jamespilgrim/PiTrac/Documentation/PiTrac - DIY LM  Parts List.md

**PiTrac \- DIY LM  Parts Lists**

**Computing Hardware:**

| Quantity | Hardware | Purpose |
| :---- | :---- | :---- |
| 1 | [Raspberry Pi 5](https://www.raspberrypi.com/products/raspberry-pi-5/) and power supply, 4 GB minimum, 8 FB recommended. | Getting a bundled kit with the Pi and power supply and some other things can be economical if you don’t have any Pi-related stuff yet. |
| 1 | [Raspberry Pi 4 Model B](https://www.raspberrypi.com/products/raspberry-pi-4-model-b/) and power supply, 4 GB minimum.  It may also make sense for a little more money just to get a second Pi 5\. |  |
| 1 | [Pimoroni NVMe Base for Raspberry Pi 5 \- PIM699](https://www.adafruit.com/product/5845) ((optional, but recommended for speed and longevity). [This board](https://www.amazon.com/gp/product/B0CQ4D2C9S/ref=ppx_yo_dt_b_search_asin_title?ie=UTF8&psc=1) works well, too. | For the Pi 5, this allows use of an NVMe memory drive instead of an MicroSD card. |
| 1 | An [NVMe solid state (SSD) memory drive](https://www.amazon.com/gp/product/B0BGFRZDTB/ref=ppx_yo_dt_b_search_asin_title?ie=UTF8&psc=1) (optional, but recommended for speed and longevity) | Typically with an M.2 M key edge connector, in the 2230 and 2242 form factors.  Should probably get at least 256 GB capacity. |
| 2 | Micro SD cards (to bootstrap the Pi’s). | We recommend 64GB size |
| 1 | An Active Cooler fan for the Pi 5 (optional) | The Pi 5 can get pretty hot if you’re doing a lot of big compiles on it.  If so, having a cooler seems like decent insurance. |

**Hardware \- Bolts and Nuts:[^1]**

| Quantity | Hardware | Purpose |
| :---- | :---- | :---- |
| 4 | M4 x 12 screws | LED Power supply hold-downs |
|  |  |  |
| 4 | 2.5M x 12mm bolt | Pi 1 Board Bolt-down |
| 4 | 2.5 Hex Nuts | Pi 1 Board Bolt-down |
| 3 | 2.5M x 10mm bolt | Pi 2 Board Bolt-down |
| 1 | 2.5M x 12mm bolt (odd one\!) | Pi 2 Board Bolt-down |
|  |  |  |
| 2 x 4 | 2.5M x 16mm 2.5 Hex Nuts | Pi Camera Attachment Bolts (to back plate) |
| 3 x 2 3 x 2 | M4 x 12mm  M4 Hex Nuts  | Pi Cam Gimbal Attachment Hinge (2 cameras and strobe gimbal) |
| 2 x 1 2 x 1 | M5 x 12 M5 Hex Nut | Pi Cam (Pan) Swivel Mount (on bottom of mount) |
|  |  |  |
| 3 x 2 | M3 | Horizontal Center-Side Body Attachment |
| 4 | 2.5 x 10 or 12 | Connector Board Bolt-down |
| 3 x 6 \= 18 | M3 x 10mm | Floor hold-down screws |
|  |  |  |
| 2 x 4 | 2.5M x 12mm bolt | Connector Board Mounting Bolts |
| 2 x 4 | 2.5 Hex Nuts | Connector Board Mounting Bolts |
| 8 | M3 x 10mm | LED and LED Lens Hold-down screws |
|  |  |  |
| 2 2 | M3 x 12mm M3 Nuts | Half-Join bolts and nuts for ceiling level walls |
| 2 2 | M3 x 16mm M3 Nuts | Half-Join bolts and nuts for base and middle level walls |
| 5 x 4 | M3 x 10mm self-tapping screws | These screws secure the five “floor” components to their respective “wall” components and/or other floor components |

**Camera and Lighting Hardware:**

| 2  | [Raspberry Pi Global Shutter Camera – CS Lens Mount](https://www.adafruit.com/product/5702) | The cameras currently used by the LM.  They do not come with lenses (see below) |
| :---- | :---- | :---- |
| 1 | [Raspberry Pi 5 FPC Camera Cable \- 22-pin 0.5mm to 15-pin 1mm \- 300mm long](https://www.adafruit.com/product/5819) | The current Pi Cameras have a CSI cable that needs a conversion to fit into the smaller CSI ports on the Pi 5\.  The 200mm should probably work as well. |
|  | [200 mm Flex Cable for Pi 4](https://www.adafruit.com/product/2087) | This likely comes with most Pi Cameras, so may not be necessary |
| 2 | [6mm 3MP Wide Angle Lens for Raspberry Pi HQ Camera \- 3MP](https://www.adafruit.com/product/4563) | Wide angle lens for the Pi GS cameras (which come without a lens) |
| 1 | [1" x 1", Optical Cast Plastic IR Longpass Filter](https://www.edmundoptics.com/p/1quot-x-1quot-optical-cast-plastic-ir-longpass-filter/5421/) (1.5mm nominal thickness) | Blocks visible light below 850nm from entering the Camera 2 sensor |
|  |  |  |
| 1 | [60 / 120 Degree LED Lens Optical Glass 44mm \+ Reflector Collimator \+ Fixed Bracket for 20W 30W 50W 100W COB High Power Chip (60Degree 100W len kit)](https://www.amazon.com/dp/B09XK7QTV5?ref=ppx_yo2ov_dt_b_fed_asin_title)  | The lens helps focus the infrared IR light. |
| 1 | [High Power LED Chip IR 730nm (you want the 850nm) 850nm 940nm 3W 5W 10W 20W 30W 50W 100W COB Integrated Matrix Light Beads for Night Vision Camera (Select the 850NM, 100W 1Pieces)](https://www.amazon.com/dp/B09DPJYRQN?ref=ppx_yo2ov_dt_b_product_details&th=1)  | The 730nm IR Led used for strobe light.  NOTE \- this device can get very hot if left constantly on for even a few seconds.  PiTrac just uses it in short pulses. |
| 1 | [Aclorol USB COB LED Strip Lights for TV 5V USB Powered LED Tape Lights Daylight White 6.56FT 320Leds/M 6000K COB Flexible Light Strip TV Led Backlight for Bedroom Under Cabinet Kitchen DIY](https://www.amazon.com/Aclorol-Powered-Daylight-Flexible-Backlight/dp/B0D1FYV3LM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) | LED strip for lighting the teed-up ball- long enough to double it for more light. 
NOTE - The Strip should produce NO infrared light, or else it will interfere with the IR strobing that the system uses.
|

**Power-Related Parts:**

| 1  | LED Driver, 12-26V, Output Current DC 3600mA, such as: https://www.aliexpress.us/item/2251832563139779.html NOTE - Also need a power-plug for some of these drivers that just come with power wires.  For the US, see, e.g., [this](https://www.amazon.com/sspa/click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)| Driver for LED strobe array. Because of the short pulses that are used in the LM, a much smaller (and cheaper) driver may also work, possibly even a non-constant-current driver. |
| :---- | :---- | :---- |
| 1 | A 5V USB-B power supply with a male micro USB connector  | This is currently necessary to run the Connectro Board.  The supply is used as an isolated, independent (downstream of a transformer) power plane to try to keep the Pi’s and the Pi Camera safe. |
|  |  |  |

**Connector Board Parts:**

| Item | Qty | Reference(s) | Value | LibPart | Footprint / Details |  |
| :---- | :---- | :---- | :---- | :---- | :---- | ----- |
| 1 | 1 | J3 | \~ | [USB B Micro Female Pinboard](https://www.amazon.com/Pinboard-MELIFE-Interface-Adapter-Breakout/dp/B07W6T97HZ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) | The included Pin headers can be used for the parts below |  |
| 2 | 2 | R1, R4 | 330 ohm R | Resistor A decent assortment kit is [here](https://www.amazon.com/gp/product/B003UC4FSS/ref=ppx_yo_dt_b_search_asin_title?ie=UTF8&psc=1) | Resistor\_THT:R\_Axial\_DIN0207\_L6.3mm\_D2.5mm\_P10.16mm\_Horizontal |  |
| 3 | 2 | R2, R3 | 270 ohm R | Resistor | Resistor\_THT:R\_Axial\_DIN0207\_L6.3mm\_D2.5mm\_P10.16mm\_Horizontal |  |
| 5 | 1 | Sys1\_Conn1 | \~ | 4 Pin Header | Connector\_PinHeader\_2.54mm:PinHeader\_1x04\_P2.54mm\_Vertical |  |
| 6 | 1 | Sys2\_Conn1 | \~ | 3 Pin Header | Connector\_PinHeader\_2.54mm:PinHeader\_1x03\_P2.54mm\_Vertical |  |
| 7 | 2 | U2, U3 | H11L1 | [Isolator:H11L1](https://www.amazon.com/dp/B09KM2BJCF?ref_=pe_386300_442618370_TE_sc_as_ri_0) | Package\_DIP:DIP-6\_W7.62mm |  |
| 8 | 1 | U4 | 74HC04 | 74xx:74HC04 | Package\_DIP:DIP-14\_W7.62mm\_Socket |  |
| 9 | 1 | U5 | \~ | [Dual\_Mos\_Driver\_Module](https://www.amazon.com/Anmbest-High-Power-Adjustment-Electronic-Brightness/dp/B07NWD8W26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) | Verdant\_Custom\_Footprint\_Library:PCB Dual MOS Driver Module |  |
|  | 1 | 2.5M Bolt 2.5M Nut |  |  | These help mechanically tie down the USB-B power connector to the board |  |
|  |  | \<Optional\> |  |  |  |  |
|  | 2 | 6 \- pin DIP socket |  | A decent assortment kit is [here](https://www.amazon.com/dp/B01GOLSUAU?ref=ppx_yo2ov_dt_b_fed_asin_title) | The opto-isolators and the hex inverter chip are probably the most likely to be blown up or injured by solder over-temps.  So best to put them in sockets |  |
|  | 1 | 14 \- pin DIP socket |  | A decent assortment kit is [here](https://www.amazon.com/dp/B01GOLSUAU?ref=ppx_yo2ov_dt_b_fed_asin_title) |  |  |

**Miscellaneous Parts/Supplies:**

| Quantity | Hardware | Purpose / Notes |
| :---- | :---- | :---- |
| 2 |  [Ideal Industries 30-102 Power Plug](https://www.amazon.com/Ideal-Industries-30-102-Power-72427/dp/B01LYF1WV9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). | Enables easy connect/disconnects |
| N/A | 3 and 4-pin ribbon cables For example, [here](https://www.amazon.com/Kidisoii-Dupont-Connector-Pre-Crimped-5P-10CM/dp/B0CCV1HVM9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). | These are used for the wiring harness connects between the various GPIO pins and the Connector Board |
| 1 | 15.5cm x 24cm plexiglass anti-ball-strike protective window | Protects the cameras and strobe **NOTE:**  Ensure the plexi is not IR-blocking\!  Most hardware stores can cut plexi in this size for a few US$ |
| 1 | Power Strip | A relatively short power strip that is compact enough to fit into the enclosure. 10” or less, and with some type of power filtering to protect the rest of the components |

[^1]:  Stainless Steel seems to be stronger than black carbon steel, though both can work.  Especially in the stiffer PLA material, stainless is preferable because black carbon can break if torqued too much..  For parts supply example see [HanTof 525 Pcs 304 Stainless Steel M2 M3 M4 Phillips Pan Head Self Tapping Wood screws Assortment Kit](https://www.googleadservices.com/pagead/aclk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).,
