jamespilgrim/PiTrac/3D Printed Parts/Enclosure Version 2/BaseBox/BaseBox- Main Body.3mf

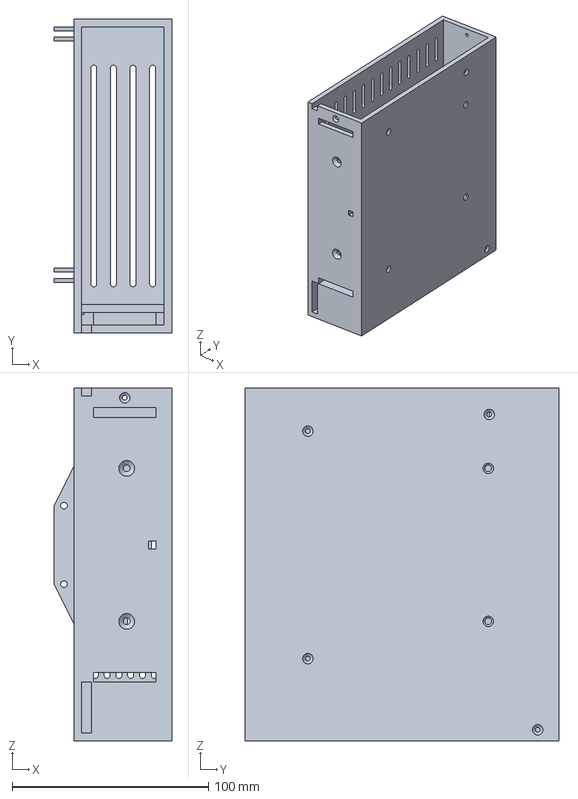
[picture p25: CAD file, 2025-03-30]
3D Printed Parts/Enclosure Version 2/BaseBox/BaseBox- Main Body.3mf
60.0 x 160.0 x 180.0 mm
