jamespilgrim/PiTrac/3D Printed Parts/Enclosure Version 2/Calibration Rig/Calibration Rig.3mf

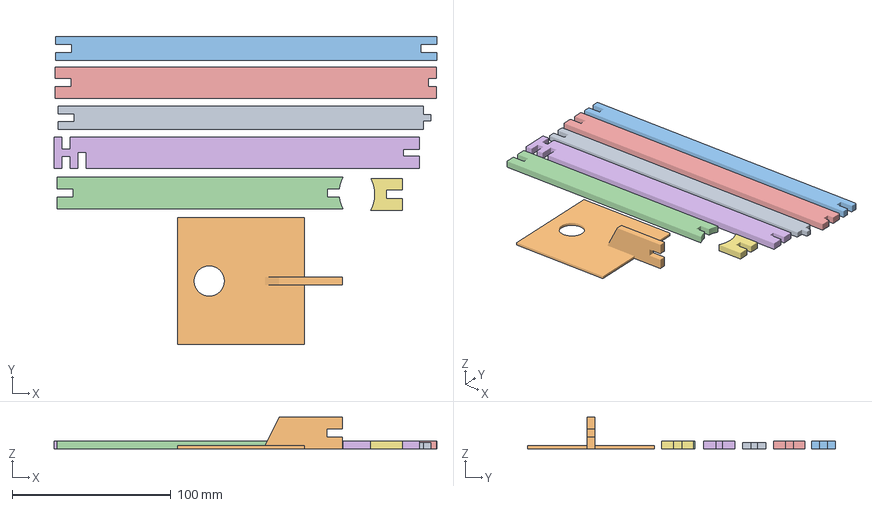
[picture p27: CAD file, 2025-04-10]
3D Printed Parts/Enclosure Version 2/Calibration Rig/Calibration Rig.3mf
241.1 x 194.0 x 20.0 mm
Calibration Rig.stl_1
Calibration Rig.stl_2
Calibration Rig.stl_3
Calibration Rig.stl_4
Calibration Rig.stl_5
Calibration Rig.stl_6
Calibration Rig.stl_8
