jamespilgrim/PiTrac/3D Printed Parts/Enclosure Version 2/LED-Array-Strobe-Light-Mount/LED Light Mount.FCStd

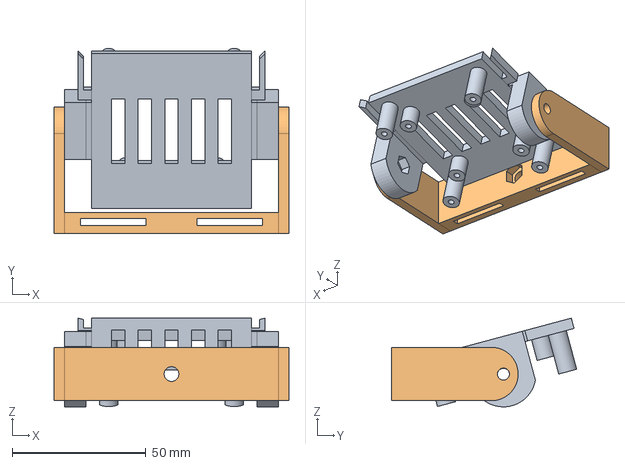
[picture p30: CAD file, 2025-03-30]
3D Printed Parts/Enclosure Version 2/LED-Array-Strobe-Light-Mount/LED Light Mount.FCStd
88.0 x 69.4 x 33.2 mm
LED Back Plate
LED Gimbal
