jamespilgrim/PiTrac/3D Printed Parts/Enclosure Version 2/Pi-Camera-Light-Filter-Holder/Pi Cam Filter Holder.FCStd

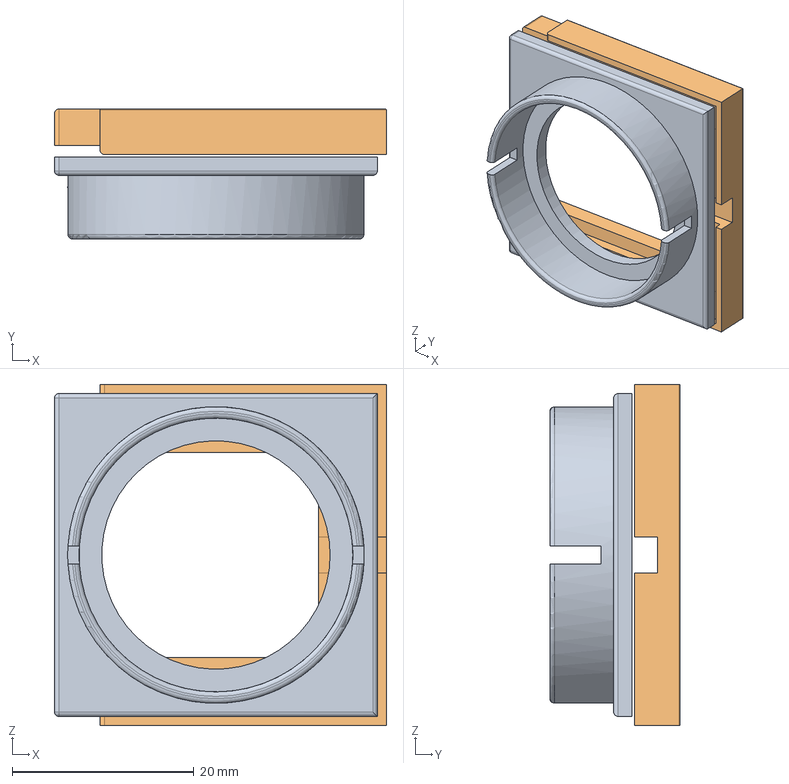
[picture p31: CAD file, 2025-03-30]
3D Printed Parts/Enclosure Version 2/Pi-Camera-Light-Filter-Holder/Pi Cam Filter Holder.FCStd
36.5 x 14.3 x 37.5 mm
Filter Holder Body
Holder Wings Body
