jamespilgrim/PiTrac/3D Printed Parts/Enclosure Version 2/Calibration Rig/CalibrationRigFCStd.FCStd

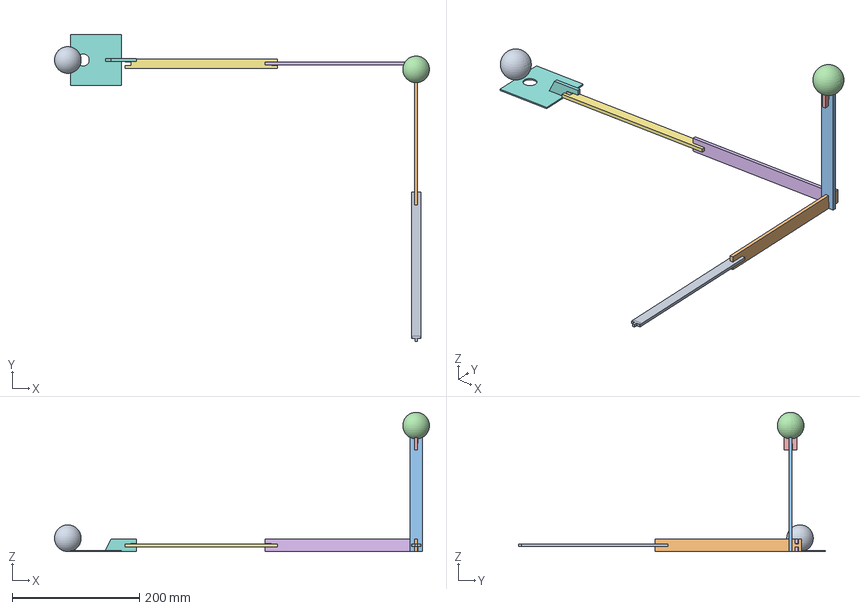
[picture p35: CAD file, 2025-04-10]
3D Printed Parts/Enclosure Version 2/Calibration Rig/CalibrationRigFCStd.FCStd
588.7 x 481.9 x 218.9 mm
Base Connection Leg Body
Z-Axis Leg Body
High Ball Holder Body
Test Golf Ball 1
High Ball Holder Cross Body
X Axis Near Leg
X Axis Far Leg
X-Axis Ball Holder Body
Test Golf Ball 2
