jamespilgrim/PiTrac/3D Printed Parts/Enclosure Version 2/Tower-Connector-Board-Variant/Tower Frontplate Body.stl

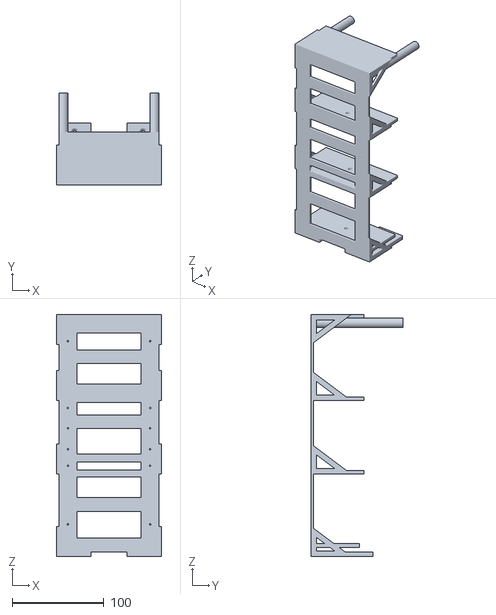
[picture p39: CAD file, 2025-04-14]
3D Printed Parts/Enclosure Version 2/Tower-Connector-Board-Variant/Tower Frontplate Body.stl
114.6 x 100.7 x 264.0
