jamespilgrim/PiTrac/3D Printed Parts/Enclosure Version 2/BaseBox/BaseBox-End Cap.3mf

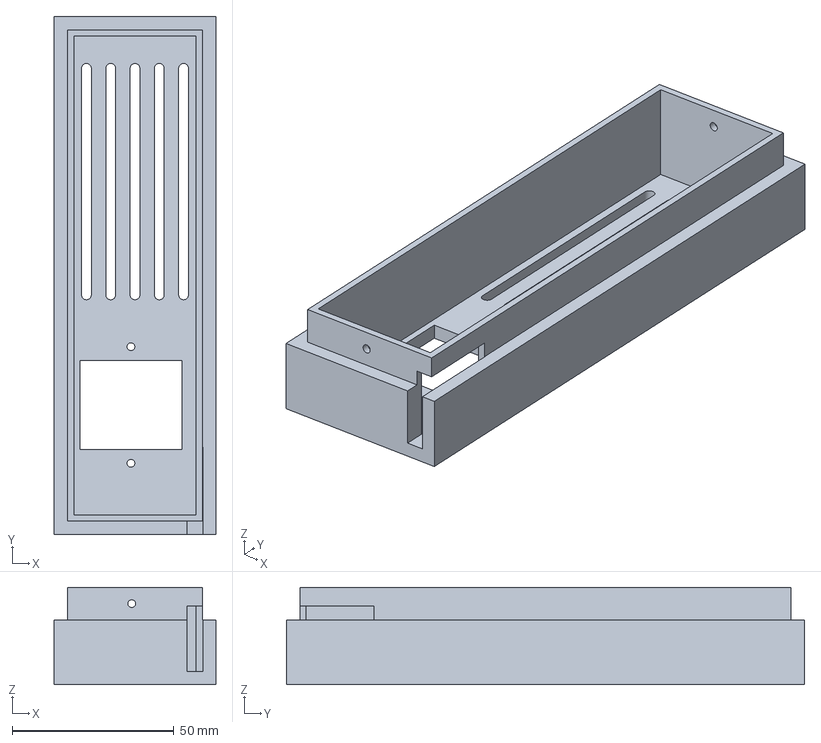
[picture p51: CAD file, 2025-03-30]
3D Printed Parts/Enclosure Version 2/BaseBox/BaseBox-End Cap.3mf
50.0 x 160.0 x 30.0 mm
