jamespilgrim/PiTrac/(list of files, cad)

Other CAD files:
3D Printed Parts/Enclosure Version 2/Master Document.FCStd
3D Printed Parts/Enclosure Version 2/Pi-Camera-Light-Filter-Holder/Pi Cam Filter Holder v1.00.FCStd
3D Printed Parts/Enclosure Version 2/CaseCover/CaseCover - BACKUP.FCStd
3D Printed Parts/Enclosure Version 2/Pi-Camera-Light-Filter-Holder/Master Document.FCStd
3D Printed Parts/Enclosure Version 2/BaseBox/CaseCover-BaseBox Part.stl
3D Printed Parts/Enclosure Version 2/BaseBox/BaseBox-BaseBox PartLight Shield Body.stl
3D Printed Parts/Enclosure Version 2/BaseBox/C14 Panel Mount Power Plug Adapter w Fuse - JR-101-1F.FCStd
3D Printed Parts/Enclosure Version 2/BaseBox/BaseBox- Light Shield Body.stl
3D Printed Parts/Enclosure Version 2/BaseBox/BaseBox- Main Body - OLD.3mf
3D Printed Parts/Enclosure Version 2/BaseBox/BaseBox- Main Body - OLD.stl
3D Printed Parts/Enclosure Version 2/BaseBox/BaseBox- Main Body.stl
3D Printed Parts/Enclosure Version 2/BaseBox/BaseBox-End Cap.stl
3D Printed Parts/Enclosure Version 2/Calibration Rig/Calibration Rig.stl
3D Printed Parts/Enclosure Version 2/CaseCover/Lower Case Cover Body.stl
3D Printed Parts/Enclosure Version 2/CaseCover/Upper Case Cover Body.stl
3D Printed Parts/Enclosure Version 2/Integrated Enclosure (DO NOT PRINT)/BACKUPS/1/Integrated PiTrac.FCStd
3D Printed Parts/Enclosure Version 2/Integrated Enclosure (DO NOT PRINT)/BACKUPS/1/Pi HQ Camera.FCStd
3D Printed Parts/Enclosure Version 2/Integrated Enclosure (DO NOT PRINT)/BACKUPS/2/Integrated PiTrac.FCStd
3D Printed Parts/Enclosure Version 2/Integrated Enclosure (DO NOT PRINT)/BACKUPS/2/Pi HQ Camera.FCStd
3D Printed Parts/Enclosure Version 2/Integrated Enclosure (DO NOT PRINT)/BACKUPS/Integrated PiTrac - BACKUP.FCStd
3D Printed Parts/Enclosure Version 2/Integrated Enclosure (DO NOT PRINT)/BACKUPS/Integrated PiTrac - Copy.FCStd
3D Printed Parts/Enclosure Version 2/LED-Array-Strobe-Light-Mount/LED Light Mount.3mf
3D Printed Parts/Enclosure Version 2/LED-Array-Strobe-Light-Mount/LED Light Mount.stl
3D Printed Parts/Enclosure Version 2/Pi-Camera-Light-Filter-Holder/Pi Cam Filter Holder.3mf
3D Printed Parts/Enclosure Version 2/Pi-Camera-Light-Filter-Holder/Pi Cam Filter Holder.stl
3D Printed Parts/Enclosure Version 2/Pi-Camera-Mounts/Camera Mount - Bottom Variation.stl
3D Printed Parts/Enclosure Version 2/Pi-Camera-Mounts/Camera Mount - Top Variation.stl
3D Printed Parts/Enclosure Version 2/Pi-Camera-Mounts/OLD - DELETE - Master Document.FCStd
3D Printed Parts/Enclosure Version 2/Tower-Connector-Board-Variant/Tower Backplate Body - Connector Board Variant - Split Pieces.stl
3D Printed Parts/Enclosure Version 2/Tower-Connector-Board-Variant/Tower Frontplate Body - Connector Board Variant - Split Pieces.stl
