jamespilgrim/PiTrac/Software/LMSourceCode/Testing/TestSuite_2025_02_07/Uneekor Comparison 2025-02-07_Small_Test.csv

Shot | Speed | VLA | HLA | Back Spin | Side Spin | Ignore
1 | 66.6 | 19.1 | -5.6 | 3987 | -355 | FALSE
2 | 54.5 | 10.9 | -4 | 1686 | -1048 | TRUE
3 | 60.5 | 14.5 | -5.5 | 2137 | -1421 | FALSE
