jamespilgrim/PiTrac/Software/LMSourceCode/ImageProcessing/libcamera_interface.h

/* SPDX-License-Identifier: GPL-2.0-only */
/*
 * Copyright (C) 2022-2025, Verdant Consultants, LLC.
 */

// This is the main interface between the LM and the underlying libcamera system.

#pragma once

#ifdef __unix__  // Ignore in Windows environment

#include "core/rpicam_app.hpp"
#include "core/rpicam_encoder.hpp"
#include "core/still_options.hpp"

#include <opencv2/core.hpp>

#include "golf_ball.h"
#include "gs_camera.h"
#include "gs_options.h"

#include "still_image_libcamera_app.hpp"



namespace golf_sim {

	// TBD - Put in a struct or class sometime

	class LibCameraInterface {
	public:

		// The Camera 1 operates in a cropped mode only when watching the teed-up ball for a 
		// hit.  Otherwise, while watching for the ball to be teed up in the first place, the
		// camera operates at full resolution.
		enum CropConfiguration {
			kCropUnknown,
			kFullScreen,
			kCropped
		};

		enum CameraConfiguration {
			kNotConfigured,
			kStillPicture,
			kHighSpeedWatching,
			kExternallyStrobed
		};

		static cv::Mat undistort_camera_image(const cv::Mat& img, GsCameraNumber camera_number, CameraHardware::CameraModel cameraModel);
		static bool SendCamera2PreImage(const cv::Mat& raw_image);
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
