jamespilgrim/PiTrac/(commit log)

2025-03-30 Adding new Version 2 Enclosure 3D models and documents.
    [Backplate - Copy (2).FCStd, Backplate - Copy.FCStd, Backplate.FCStd, BaseBox- Light Shield Body.3mf, BaseBox- Light Shield Body.stl, BaseBox- Main Body - OLD.3mf, BaseBox- Main Body - OLD.stl, BaseBox- Main Body.3mf]
2025-04-01 Adding new Version 2 Enclosure 3D Model for Pi4-5 and Connector Board Tower.
    [Tower Backplate Bodies.3mf, Tower Backplate Body - Connector Board Variant.stl, Tower Backplate Body.stl, Tower Frontplate - Both Pieces (split).3mf, Tower Frontplate Body - Lower Half.3mf, Tower Frontplate Body - Upper Half.3mf, Tower Frontplate Body.stl, Tower.FCStd]
2025-04-03 Adding some notes for the future version 2 enclosure assembly manual.
2025-04-04 Fixed a couple problems with basebox height parameterization to make it easier to stretch it vertically.
    [BaseBox.FCStd, Master Document.FCStd]
2025-04-07 Added cross-bracing between the fingers of the upper half of the case to reduce vibration-induced print problems. Also added cooling slots near the Pi Compute Moduels.
    [CaseCover.FCStd, Master Document.FCStd, Upper Case Cover Body.stl, UpperCase Cover Body.3mf]
2025-04-10 Added calibration rig to help with auto-calibration process.
    [Calibration Rig.3mf, Calibration Rig.stl, CalibrationRigFCStd.FCStd]
2025-04-14 Recreated Connector-Board-Variant of the Tower model. Now includes pre-split parts.
    [Tower Backplate Body - Connector Board Variant - Split Pieces.3mf, Tower Backplate Body - Connector Board Variant - Split Pieces.stl, Tower Backplate Body.stl, Tower Frontplate Body - Connector Board Variant - Split Pieces.3mf, Tower Frontplate Body - Connector Board Variant - Split Pieces.stl, Tower Frontplate Body.stl, Tower.FCStd]
2025-04-15 Adding the start of auto-calibration, improved ball-identification parameters, and some code changes to help accomodate left-handed golfing. Also finished the camera2 still image code.
2025-04-15 Adding missing files to support adding the start of auto-calibration, improved ball-identification parameters, and some code changes to help accomodate left-handed golfing. Also finished the camera2 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
    [lm_main.cpp]
2025-04-15 Added Testing directory to support automated testing and left-handed operations.
    [PiTrac_Test_Results.csv, Uneekor Comparison 2025-02-07 - Full.csv, Uneekor Comparison 2025-02-07_Small_Test.csv, comparison template.csv]
